scramble-ssl/wheel_BLDCMD_brd/bldcmd_ver1.brd

## EAGLE design bldcmd_ver1.brd (2018-02-21)

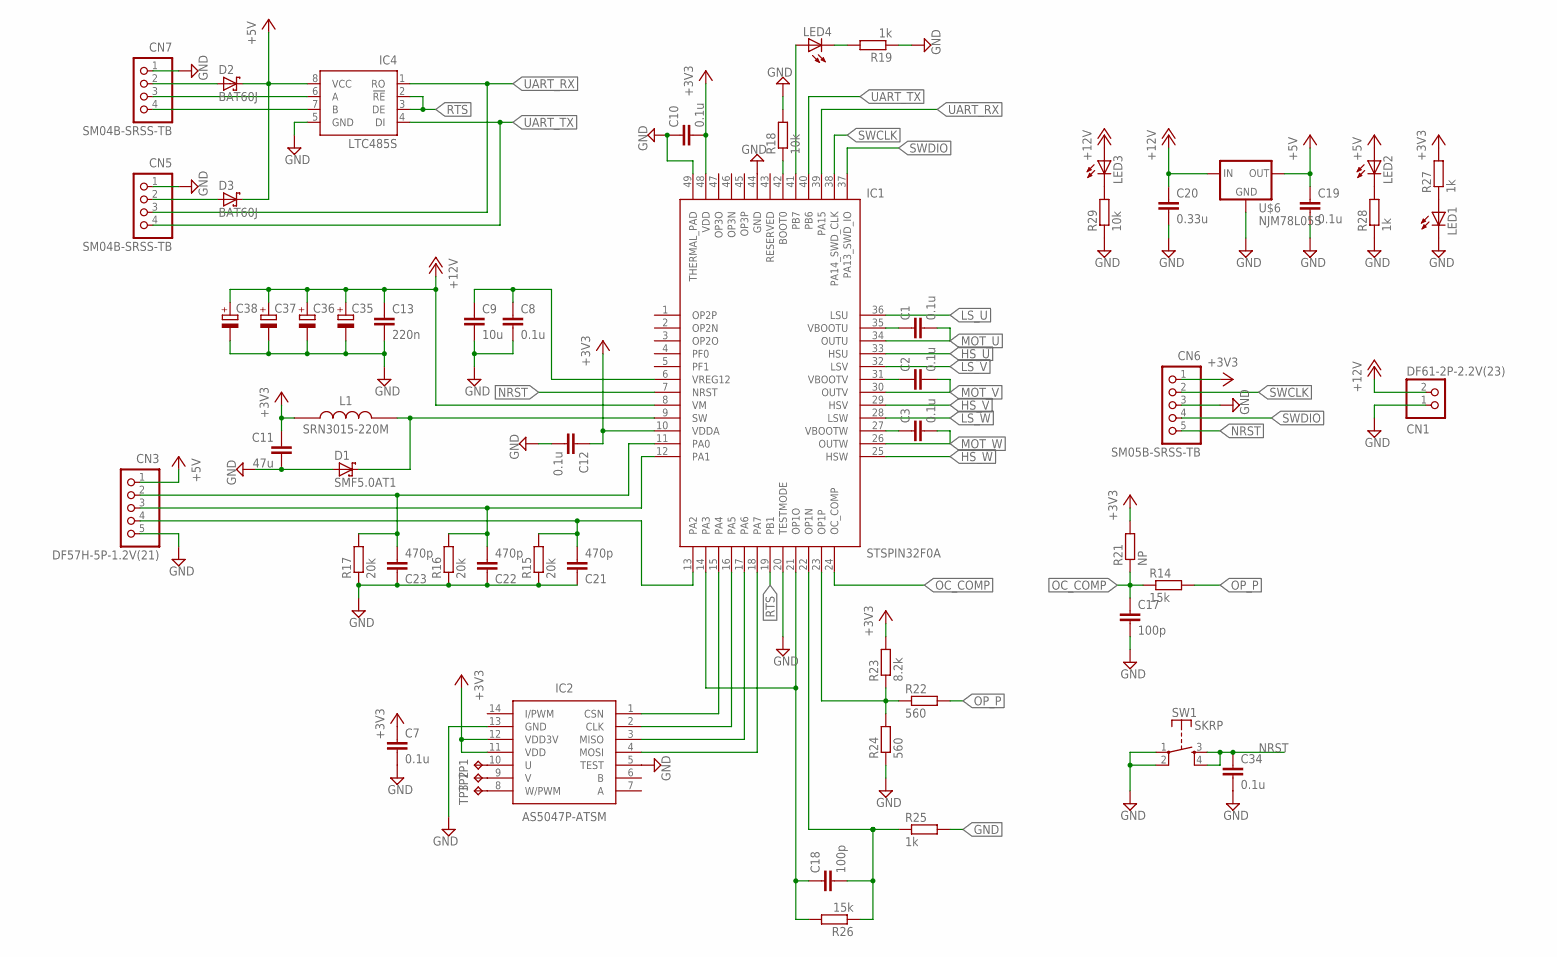
[picture p1: schematic bldcmd_ver1.sch, sheet 1]

Parts:
C1, C2, C3: 0.1u; C0402
C7, C8, C10, C12, C19, C34: 0.1u; C0603K
C9: 10u; C0805K
C11: 47u; C1206K
C13: 220n; C0805K
C17, C18: 100p; C0402
C20: 0.33u; C0805K
C21, C22, C23: 470p; C0402
C35, C36, C37, C38: CPOL-EU153CLV-0605; 153CLV-0605
CN1: DF61-2P-2.2V(23); DF61-2P-2.2V
CN3: DF57H-5P-1.2V(21)
CN5, CN7: SM04B-SRSS-TB
CN6: SM05B-SRSS-TB
D1: SMF5.0AT1; SOD123FL
D2, D3: BAT60J; SOD323_ST
IC1: STSPIN32F0A; VFQFPN48_7X7X1.0-48L
IC2: AS5047P-ATSM; SOP65P640X120-14N
IC4: LTC485S; SOIC8
L1: SRN3015-220M; SRN3015
LED1, LED2, LED3, LED4: LEDSML0603; SML0603
R14, R26: 15k; R0402
R15, R16, R17: 20k; R0402
R18: 10k; R0402
R19, R27, R28: 1k; R0603
R21: NP; R0402
R22, R24: 560; R0402
R23: 8.2k; R0402
R25: 1k; R0402
R29: 10k; R0603
SW1: SKRP
TP1, TP2, TP3: TPTP08R; TP08R
U$6: NJM78L05S; SOT89R

Connections:
+3V3: C7.1, C10.2, C11.1, C12.1, CN6.1, IC1.10 (VDDA), IC1.48 (VDD), IC2.11 (VDD), IC2.12 (VDD3V), L1.1, R21.2, R23.2, R27.2
+5V: C19.1, CN3.1, D2.C, D3.C, IC4.8 (VCC), LED2.A, U$6.2 (OUT)
+12V: C13.1, C20.1, C35.+, C36.+, C37.+, C38.+, CN1.2, IC1.8 (VM), LED3.A, U$6.1 (IN); also elsewhere on the board
GND: C7.2, C8.2, C9.2, C10.1, C11.2, C12.2, C13.2, C17.2, C19.2, C20.2, C21.1, C22.1, C23.1, C34.2, C35.-, C36.-, C37.-, C38.-, CN1.1, CN3.5, CN5.1, CN6.3, CN7.1, D1.A, IC1.20 (TESTMODE), IC1.44 (GND), IC1.49 (THERMAL_PAD), IC2.5 (TEST), IC2.13 (GND), IC4.5 (GND), LED1.C, R15.1, R16.1, R17.1, R18.2, R19.1, R24.1, R25.2, R28.1, R29.1, SW1.1, SW1.2, U$6.3 (GND), U$6.4 (GND); also elsewhere on the board
HS_U: IC1.33 (HSU); also elsewhere on the board
HS_V: IC1.29 (HSV); also elsewhere on the board
HS_W: IC1.25 (HSW); also elsewhere on the board
LS_U: IC1.36 (LSU); also elsewhere on the board
LS_V: IC1.32 (LSV); also elsewhere on the board
LS_W: IC1.28 (LSW); also elsewhere on the board
MOT_U: C1.2, IC1.34 (OUTU); also elsewhere on the board
MOT_V: C2.2, IC1.30 (OUTV); also elsewhere on the board
MOT_W: C3.2, IC1.26 (OUTW); also elsewhere on the board
unnamed: C3.1, IC1.27 (VBOOTW)
unnamed: IC2.10 (U), TP1.TP
unnamed: IC2.9 (V), TP2.TP
unnamed: C2.1, IC1.31 (VBOOTV)
unnamed: C1.1, IC1.35 (VBOOTU)
unnamed: IC2.8 (W/PWM), TP3.TP
unnamed: IC1.15 (PA4), IC2.1 (CSN)
unnamed: IC1.16 (PA5), IC2.2 (CLK)
unnamed: CN5.2, D3.A
unnamed: IC1.17 (PA6), IC2.3 (MISO)
unnamed: IC1.18 (PA7), IC2.4 (MOSI)
unnamed: D1.C, IC1.9 (SW), L1.2
unnamed: C8.1, C9.1, IC1.6 (VREG12)
unnamed: LED2.C, R28.2
unnamed: IC1.42 (BOOT0), R18.1
unnamed: C21.2, CN3.4, IC1.13 (PA2), R15.2
unnamed: C22.2, CN3.3, IC1.12 (PA1), R16.2
unnamed: C23.2, CN3.2, IC1.11 (PA0), R17.2
unnamed: IC1.23 (OP1P), R22.1, R23.1, R24.2
unnamed: C18.2, IC1.22 (OP1N), R25.1, R26.1
unnamed: C18.1, IC1.14 (PA3), IC1.21 (OP1O), R26.2
unnamed: CN7.3, IC4.6 (A)
unnamed: CN7.2, D2.A
unnamed: LED1.A, R27.1
unnamed: CN7.4, IC4.7 (B)
unnamed: LED4.C, R19.2
unnamed: LED3.C, R29.2
unnamed: IC1.41 (PB7), LED4.A
NRST: C34.1, CN6.5, IC1.7 (NRST), SW1.3, SW1.4
OC_COMP: C17.1, IC1.24 (OC_COMP), R14.1, R21.1
OP_P: R14.2, R22.2; also elsewhere on the board
RTS: IC1.19 (PB1), IC4.2 (!RE), IC4.3 (DE)
SWCLK: CN6.2, IC1.38 (PA14_SWD_CLK)
SWDIO: CN6.4, IC1.37 (PA13_SWD_IO)
UART_RX: CN5.3, IC1.39 (PA15), IC4.1 (RO)
UART_TX: CN5.4, IC1.40 (PB6), IC4.4 (DI)

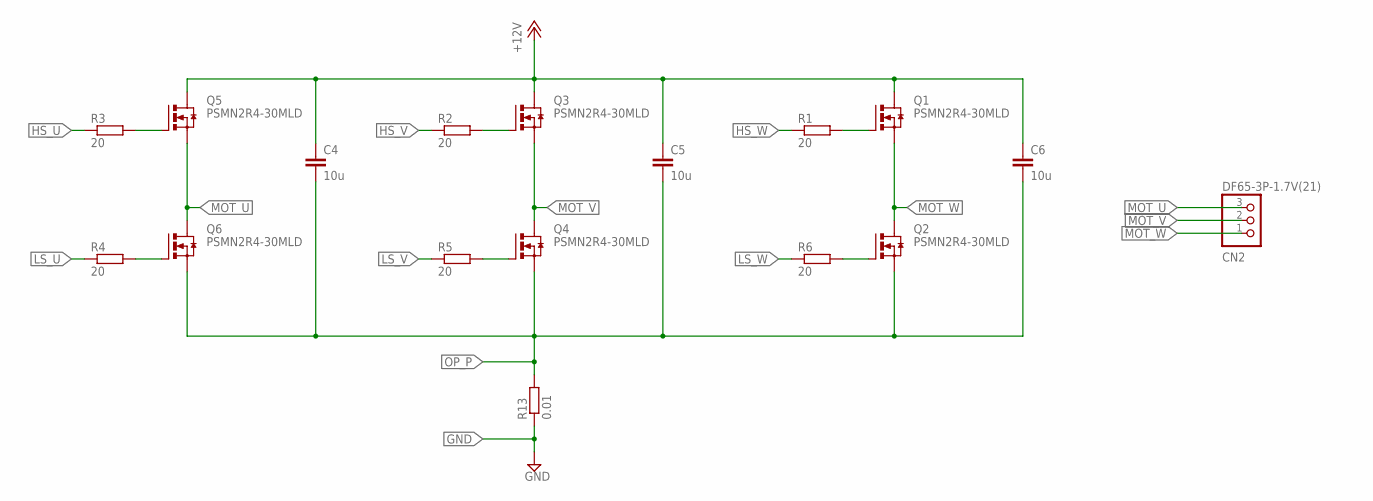
[picture p2: schematic bldcmd_ver1.sch, sheet 2]

Parts:
C4, C5, C6: 10u; C1206
CN2: DF65-3P-1.7V(21); DF65-3P-1.7V
Q1, Q2, Q3, Q4, Q5, Q6: PSMN2R4-30MLD; LFPAK33
R1, R2, R3, R4, R5, R6: 20; R0603
R13: 0.01; R3216

Connections:
+12V: C4.1, C5.1, C6.1, Q1.MB (D), Q3.MB (D), Q5.MB (D); also elsewhere on the board
GND: R13.1; also elsewhere on the board
HS_U: R3.1; also elsewhere on the board
HS_V: R2.1; also elsewhere on the board
HS_W: R1.1; also elsewhere on the board
LS_U: R4.1; also elsewhere on the board
LS_V: R5.1; also elsewhere on the board
LS_W: R6.1; also elsewhere on the board
MOT_U: CN2.3, Q5.1 (S), Q5.2 (S), Q5.3 (S), Q6.MB (D); also elsewhere on the board
MOT_V: CN2.2, Q3.1 (S), Q3.2 (S), Q3.3 (S), Q4.MB (D); also elsewhere on the board
MOT_W: CN2.1, Q1.1 (S), Q1.2 (S), Q1.3 (S), Q2.MB (D); also elsewhere on the board
unnamed: Q1.4 (G), R1.2
unnamed: Q3.4 (G), R2.2
unnamed: Q5.4 (G), R3.2
unnamed: Q6.4 (G), R4.2
unnamed: Q4.4 (G), R5.2
unnamed: Q2.4 (G), R6.2
OP_P: C4.2, C5.2, C6.2, Q2.1 (S), Q2.2 (S), Q2.3 (S), Q4.1 (S), Q4.2 (S), Q4.3 (S), Q6.1 (S), Q6.2 (S), Q6.3 (S), R13.2; also elsewhere on the board

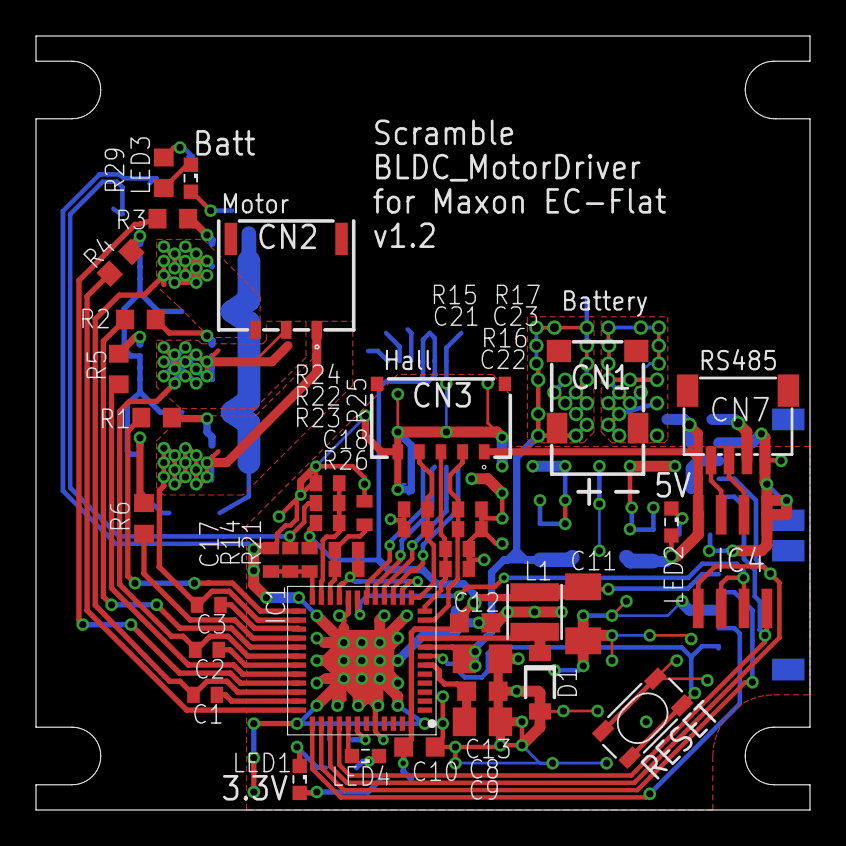
[picture p3: board bldcmd_ver1.brd from above]

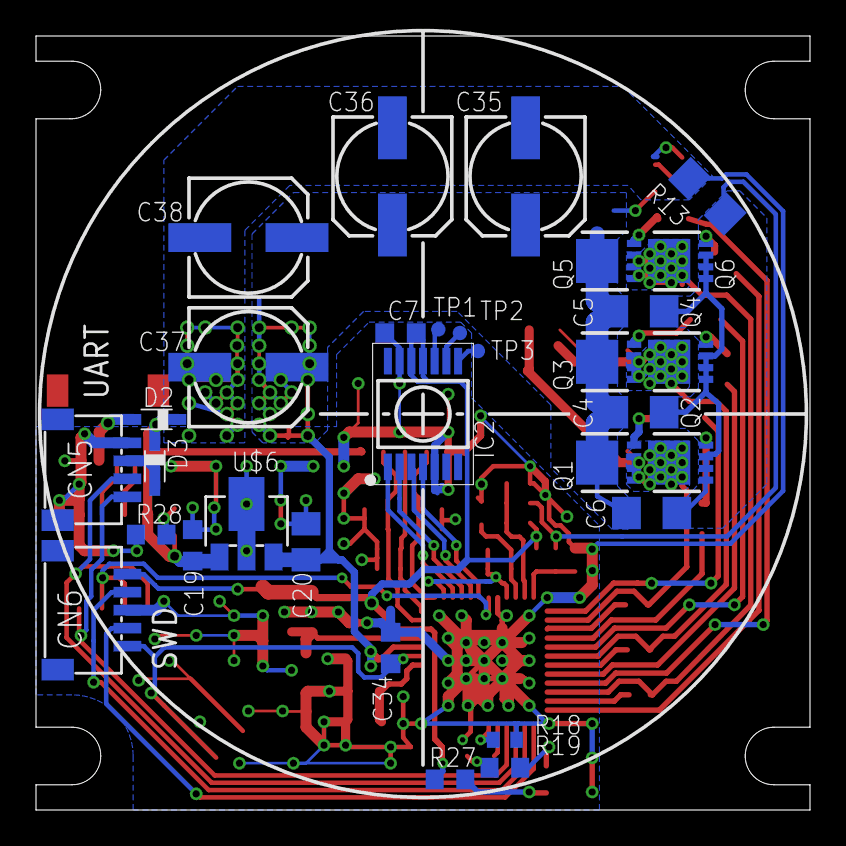
[picture p4: board bldcmd_ver1.brd from below]

Board: 2 copper layers, 43.0 x 43.0 mm, 75 parts (31 on the bottom side), 55 nets.
