scramble-ssl/wheel_BLDCMD_brd/(commit log)

2017-09-10 MCUとブリッジ回路の部品配置
    [bldcmd_ver1.brd, bldcmd_ver1.sch]
2017-09-10 磁気エンコーダAS5047P追加
    [bldcmd_ver1.brd, bldcmd_ver1.sch]
2017-09-11 CスナバをGNDからローサイドFETのソースに接続変更
    [bldcmd_ver1.brd, bldcmd_ver1.sch]
2017-09-12 部品追加
    RS485トランシーバ
    バックコンバータ用インダクタ
    パスコン
    [bldcmd_ver1.brd, bldcmd_ver1.sch]
2017-09-12 部品追加
    モータ出力コネクタ
    ネジ穴
    [bldcmd_ver1.brd, bldcmd_ver1.sch]
2017-09-17 ブリッジ回路AW攻めた
    [bldcmd_ver1.brd, bldcmd_ver1.sch]
2017-09-19 現状乗っている部品はほぼ配線完了
    [bldcmd_ver1.brd, bldcmd_ver1.sch]
2017-09-20 オペアンプつけた
    [bldcmd_ver1.brd, bldcmd_ver1.sch]
2017-09-21 5Vレギュレータと電源LED追加
    [bldcmd_ver1.brd, bldcmd_ver1.sch]
2017-09-22 コンデンサ増やした
    [bldcmd_ver1.brd, bldcmd_ver1.sch]
2017-09-23 シルクの位置調整
    [bldcmd_ver1.brd, bldcmd_ver1.sch]
2017-09-27 ホールセンサのLPFのR,Cのサイズを0402から0603に変更
    [bldcmd_ver1.brd, bldcmd_ver1.sch]
2017-10-03 12Vのテストピンの削除 RSTスイッチの向きを変更
    [bldcmd_ver1.brd, bldcmd_ver1.sch]
2017-10-03 コネクタとLEDにシルク追加
    [bldcmd_ver1.brd]
2017-11-12 電源コネクタをES9からDF61に変更
    [bldcmd_ver1.brd, bldcmd_ver1.sch]
2017-11-13 DF61-2P-2.2V(23) の修正を適用
    [bldcmd_ver1.brd, bldcmd_ver1.sch]
2017-11-13 DF65のライブラリ場所の変更を適用
    [bldcmd_ver1.brd, bldcmd_ver1.sch]
2017-11-13 #2 の対応，MCUをstspin32F0Aに変更
    [bldcmd_ver1.brd, bldcmd_ver1.sch]
2017-11-13 #3 の対応，エンコーダ入力からSPI接続に変更
    [bldcmd_ver1.brd, bldcmd_ver1.sch]
2017-11-14 修正したSHコネクタの変更を適用
    [bldcmd_ver1.brd, bldcmd_ver1.sch]
2017-11-15 ST-Linkのコネクタの接続順を入れ替えた
    [bldcmd_ver1.brd, bldcmd_ver1.sch]
2017-11-22 3端子レギュレータのライブラリ変更の反映 SHコネクタの接続順を反転
    [bldcmd_ver1.brd, bldcmd_ver1.sch]
2017-11-22 部品に必要な値を割り当てた，（最適なのか？） BOM出した
    [bldcmd_ver1.brd, bldcmd_ver1.csv, bldcmd_ver1.sch]
2017-11-23 AWを修正，コネクタの変更を適用
    [bldcmd_ver1.brd, bldcmd_ver1.sch]
2017-11-23 シルクの修正 これで発注した
    [bldcmd_ver1.brd]
2017-12-05 差動レシーバのシルク位置修正（シルクの修正，発注とはなんだったのか）
    [bldcmd_ver1.brd]
2017-12-13 BSコンデンサを0402inchに変更 デバッグ用のLEDを追加 BOOT0のプルダウン抵抗の追加( #4)
    [bldcmd_ver1.brd, bldcmd_ver1.sch]
2017-12-18 REG12のコンデンサの位置を調整
    [bldcmd_ver1.brd]
2017-12-27 RS485のICをSOIC8のものに変更
    [bldcmd_ver1.brd, bldcmd_ver1.sch]
2018-01-08 AW進捗
    [bldcmd_ver1.brd, bldcmd_ver1.csv, bldcmd_ver1.sch]
2018-01-27 ゲートのプルダウン抵抗取り除いた AWをかなり攻めた
    [bldcmd_ver1.brd, bldcmd_ver1.sch]
2018-01-28 基板サイズを変更した
    [bldcmd_ver1.brd]
2018-01-30 AW進捗，これで発注
    [bldcmd_ver1.brd]
2018-02-04 電解コンデンサのパターンを追加
    [bldcmd_ver1.brd, bldcmd_ver1.sch]
2018-02-07 AW修正
    [bldcmd_ver1.brd]
2018-02-10 電源ラインのセラミックコンデンサ削除
    [bldcmd_ver1.brd, bldcmd_ver1.sch]
2018-02-10 DF57のライブラリを更新たので適用
    [bldcmd_ver1.brd, bldcmd_ver1.sch]
2018-02-21 fusion360と基板の同期
    [bldcmd_ver1.brd]
