scramble-ssl/wheel_BLDCMD_brd/(notices)

Notices in the files:
parts and their libraries:
rcssl_lib: PSMN2R4-30MLDC © Nexperia B.V. 2017. All rights reserved
rcssl_lib: PSMN2R4-30MLD © Nexperia B.V. 2017. All rights reserved
